skunkforce/b129_65A_hall_effect_ACS733KLATR-65AB/README.md

# edgy_board number b129
This design is part of the [edgy board project](https://github.com/skunkforce/edgy_boards).

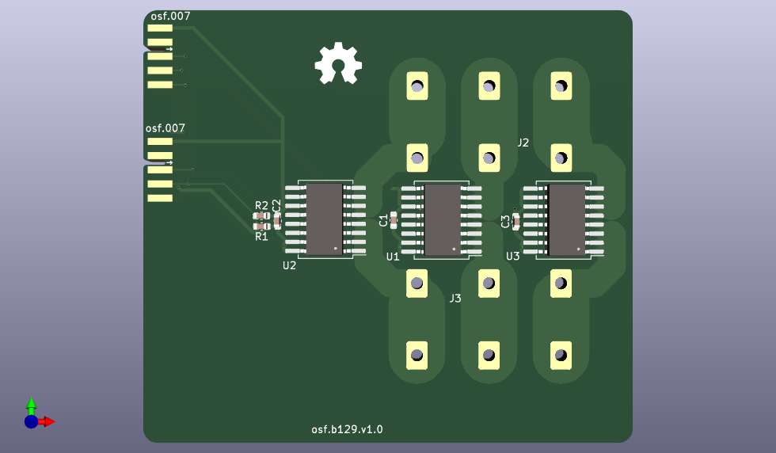
[picture p1: board/board.png]


# getting started
This repository uses submodules. After cloning use the command 

```$ git submodule update --init --recursive```

to pull the submodules before opening the project with kicad. 

# Tests
Tests can be found in [TESTS.md](TESTS.md)
