skunkforce/b129_65A_hall_effect_ACS733KLATR-65AB/board/board.kicad_pcb

## KiCad design board/board.kicad_pcb (2023-05-07)

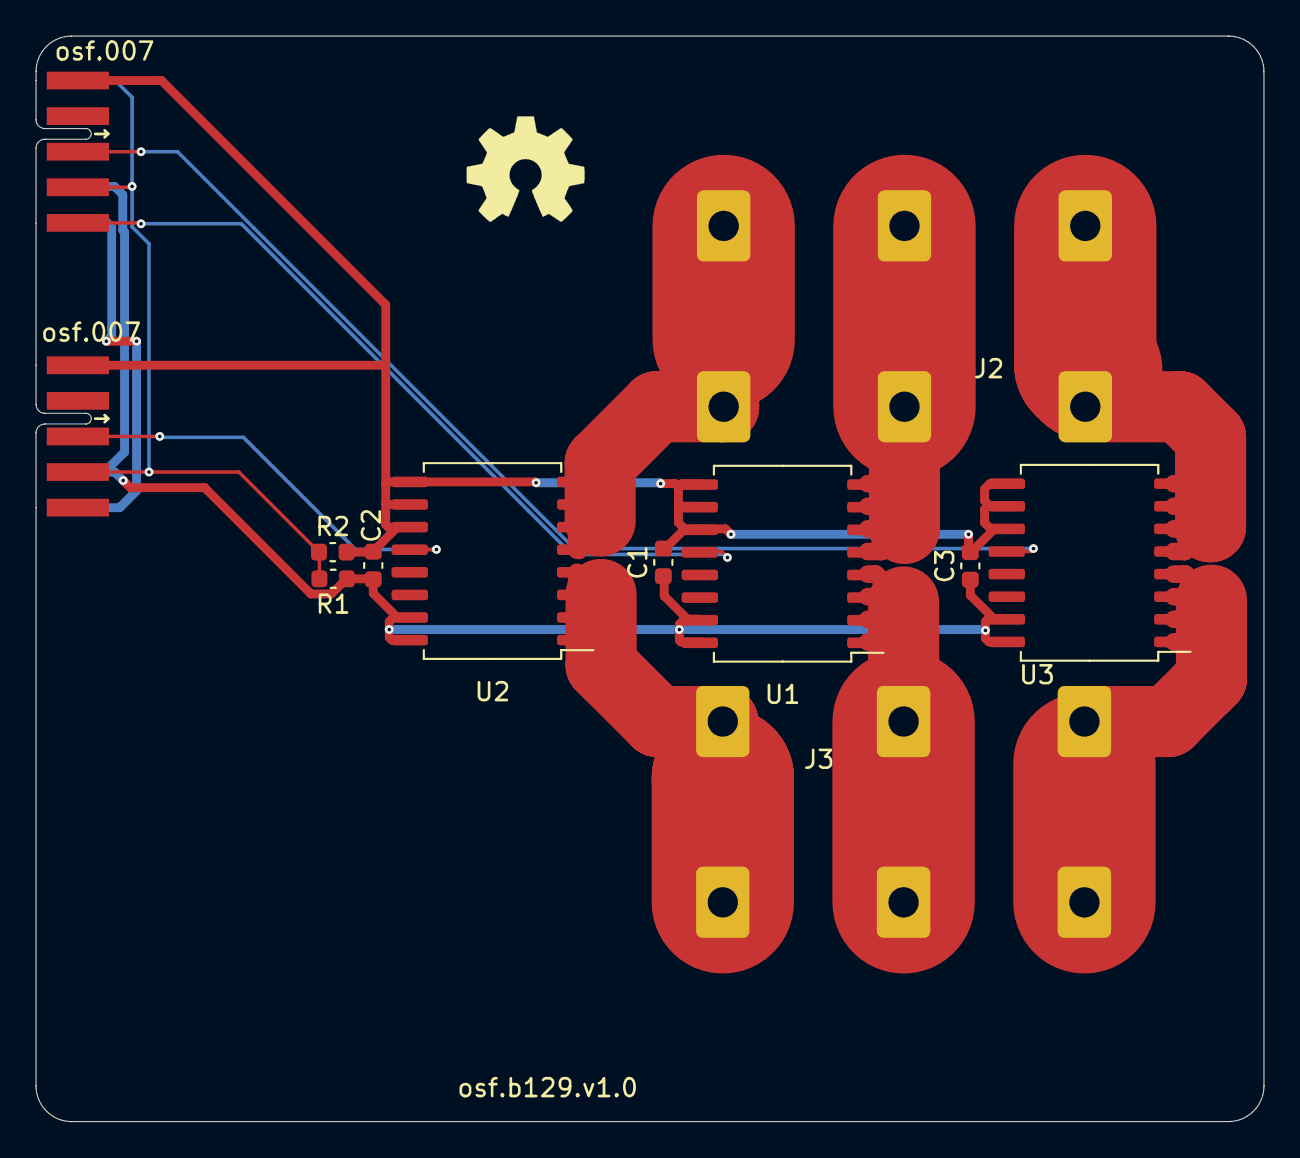
[picture p2: board board.kicad_pcb from above]

Board: 2 copper layers, 69.0 x 61.0 mm, 13 parts (0 on the bottom side), 13 nets.

Parts:
C1, C2, C3: 100nF; C_0603_1608Metric
J1, J4: 007_ADC; on_edge_2x05_device
J2, J3: VP0365540000G
LOGO1: Logo_Open_Hardware_Small; OSHW-Symbol_6.7x6mm_SilkScreen
R1, R2: 10k; C_0603_1608Metric
U1, U2, U3: ACS733KLATR-65AB-T; SOIC-16W_6.5x12.8mm_P1.27mm

Connections:
/hall1/I+: J3.1, U2.1 (IP+), U2.2 (IP+), U2.3 (IP+), U2.4 (IP+)
/hall1/I-: J2.3, U2.5 (IP-), U2.6 (IP-), U2.7 (IP-), U2.8 (IP-)
/hall1/VIOUT: J4.3 (ADC0), U2.12 (VIOUT)
/hall2/I+: J3.3, U3.1 (IP+), U3.2 (IP+), U3.3 (IP+), U3.4 (IP+)
/hall2/I-: J2.1, U3.5 (IP-), U3.6 (IP-), U3.7 (IP-), U3.8 (IP-)
/hall2/VIOUT: J1.3 (ADC0), U3.12 (VIOUT)
/hall/I+: J3.2, U1.1 (IP+), U1.2 (IP+), U1.3 (IP+), U1.4 (IP+)
/hall/I-: J2.2, U1.5 (IP-), U1.6 (IP-), U1.7 (IP-), U1.8 (IP-)
/hall/VCC: C1.1, C2.1, C3.1, J1.9 (3.3V), J4.9 (3.3V), R1.1, U1.15 (VCC), U1.16 (VCC), U2.15 (VCC), U2.16 (VCC), U3.15 (VCC), U3.16 (VCC)
/hall/VIOUT: J1.5 (ADC2), U1.12 (VIOUT)
GND: C1.2, C2.2, C3.2, J1.1 (GND), J4.1 (GND), R2.2, U1.9 (GND), U1.10 (GND), U1.11 (PROGRAM), U2.9 (GND), U2.10 (GND), U2.11 (PROGRAM), U3.9 (GND), U3.10 (GND), U3.11 (PROGRAM)
unnamed: J1.4 (ADC1), J1.6 (ADC3), J4.4 (ADC1), R1.2, R2.1
unnamed: J1.10 (5V), J4.10 (5V)
